taneken/USBKBD2X68K/images/DSC04024.jpg

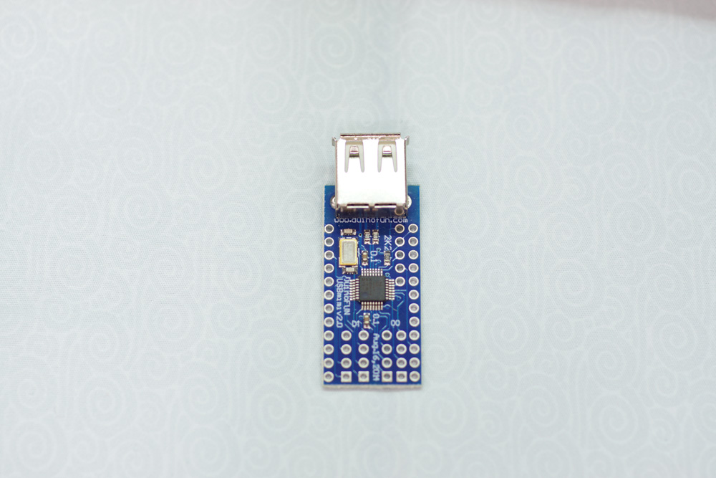
images/DSC04024.jpg
