taneken/USBKBD2X68K/images/DSC04028.jpg

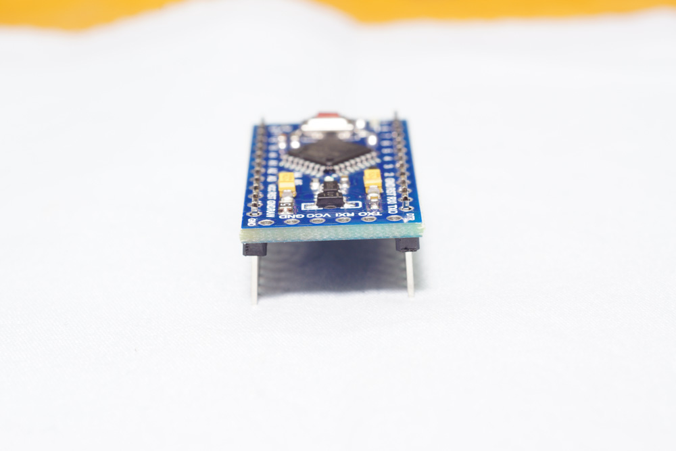
images/DSC04028.jpg
