taneken/USBKBD2X68K/images/DSC04029.jpg

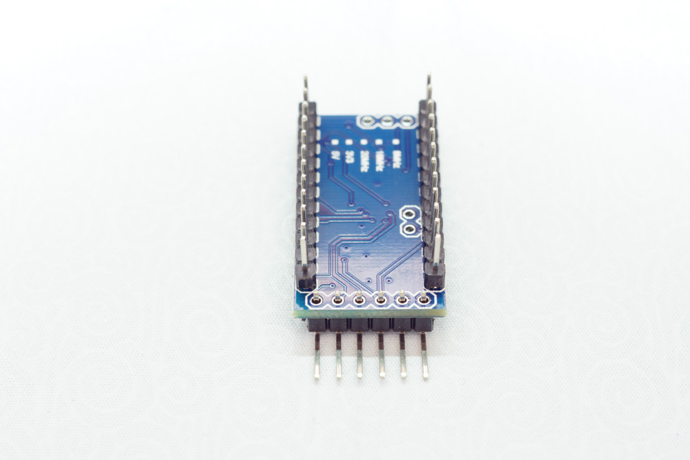
images/DSC04029.jpg
