taneken/USBKBD2X68K/images/DSC04031.jpg

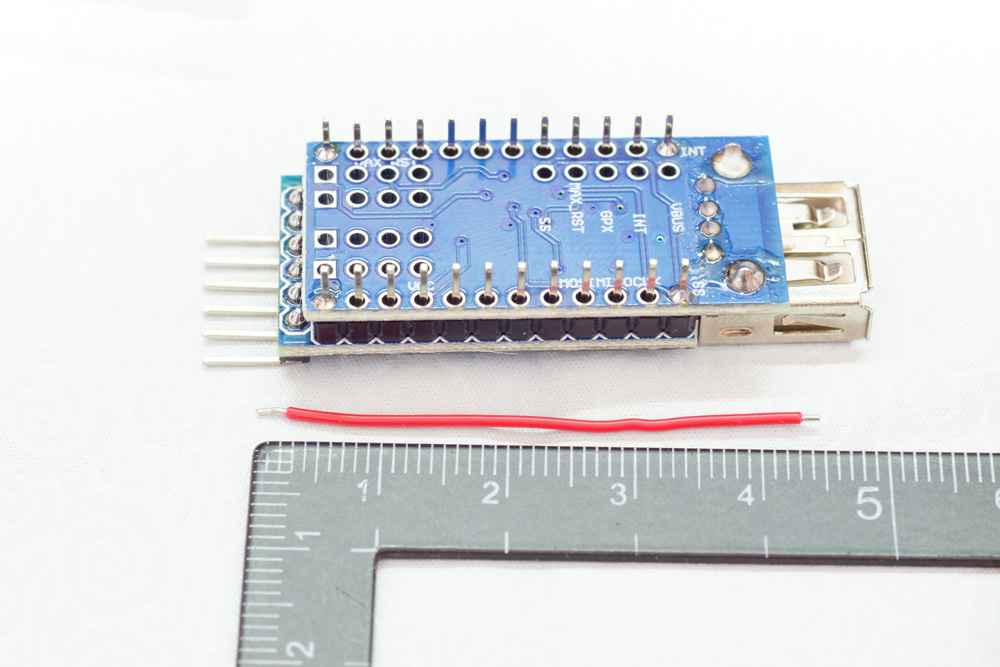
images/DSC04031.jpg
