taneken/USBKBD2X68K/USBKBD2X68K_US/usbkbs2x68k-us-keyboard-version.png

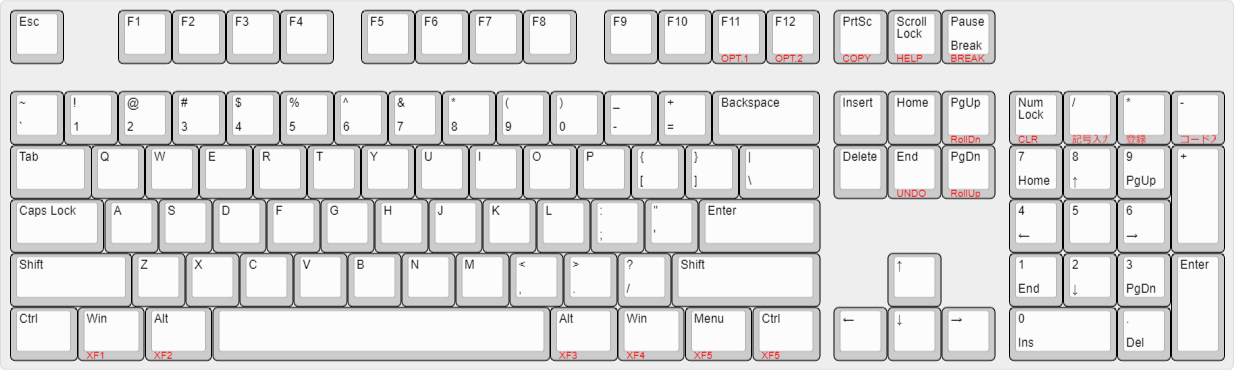
USBKBD2X68K_US/usbkbs2x68k-us-keyboard-version.png
