taneken/USBKBD2X68K/(threads)

Thread 1 (2022-01-06):

sketch too big?

Park2009, 2022-01-06:
Hello
I'm going to use it for Arduinopromini.
When attempting to compile, the message "sketch too big" was displayed and the compile was failed.
About 220kb of storage memory space seems to be insufficient.
please help me.
thanks.

I reinstalled the USB host shield library and the problem was solved.

taneken, 2022-01-07:
I'm sorry for the late reply.
You've solved it.
Older libraries are larger and can cause errors. I was also worried once.

Closed 2022-01-06.

Thread 2 (2022-04-22):

コンパイルエラーが発生しました

kikuon, 2022-04-22:
USBKBD2X68K.inoを最新のArduino IDEでコンパイルしたところ、
下記のようなエラーが出ますが何か解決方法はありますか？

最大30720バイトのフラッシュメモリのうち、スケッチが30826バイト（100%）を使っています。
最大2048バイトのRAMのうち、グローバル変数が1327バイト（64%）を使っていて、ローカル変数で721バイト使うことができます。
Sketch too big; see https://support.arduino.cc/hc/en-us/articles/360013825179 for tips on reducing it.
text section exceeds available space in board
ボードArduino Pro or Pro Miniに対するコンパイル時にエラーが発生しました。

その後、boards.txtを編集することでunoと同等にコンパイルが出来て解決しました。

Closed 2022-05-22.
