taneken/USBKBD2X68K/(commit log)

2020-11-09 とりあえず版
2020-12-29 REP_INTERVAL 100から50に変更
2020-12-30 キーリピート間隔の実装（しかし実機と挙動が異なる）
    switch.xで設定したキーリピート間隔の値をキーボードに反映させます。
    反映するタイミングは、電源投入時、リセット時。
    しかしarduinoの起動がX68000の起動に間に合わないため、電源投入時は反映されないことあり。
2020-12-30 Ver.0.2 キーリピート間隔の設定
2021-01-01 Ver.0.3 MOUSE_MODEでマウスを使用しないときはOFF出来るようにした
2021-01-20 作成手順追加
2021-01-30 MOUSE_MODEのデフォルトを1に変更
2021-02-14 Ver.0.4 MOUSE_MODE廃止,MOUSE CONTROLを実装,記号入力/登録/コード入力をテンキーに割り当て
